kedarshekhar/power_converter_monitering_system/README.md

# power_converter_monitering_system
"This project implements a real-time power converter monitoring system utilizing an ESP32 microcontroller integrated with a USR-TCP232-E2 Ethernet module. A wired Ethernet connection was explicitly chosen over wireless alternatives like Wi-Fi or Bluetooth to guarantee ultra-fast, highly reliable data transmission, achieving a communication latency as low as 4 milliseconds.

some important instruction 

1 turn off windows defender during transferring data because it not allows data coming from unauthorized data 

2 by using vcom software set ip and the port no to the rthernet module ( usr tcp 232 e2 )

3 ip of ur computer should be same network as ur tcp module ip
