kedarshekhar/power_converter_monitering_system/ESP32_Buck_Converter_Project_Report.docx

PROJECT REPORT

ESP32-Based Buck Converter Monitoring & Control System

with TFT Touch-Style UI, C2000 DSP Data Link, Ethernet Telemetry and a Python Desktop GUI

Prepared by: Kedar

Reference source files: IDE_code.ino (ESP32 firmware), python_code_gui.py (desktop GUI)

# 1. Project Overview

This project implements an embedded monitoring-and-control front end for a DC-DC buck converter. An ESP32 microcontroller drives a colour TFT display that shows live output voltage, current and power, reads a bank of six push-buttons for local control, exchanges measurement/command packets with a Texas Instruments C2000-series DSP control board over a dedicated UART link, and simultaneously streams the same telemetry to a Windows/Linux/Mac desktop application over a wired Ethernet connection so the converter can also be watched and operated remotely from a PC.

The system is built from two pieces of source code that were reviewed for this report: the ESP32 firmware written in the Arduino IDE (IDE_code.ino) and the desktop companion application written in Python using Tkinter (python_code_gui.py). The sections below describe the hardware components, the circuit/pin connections exactly as declared in the firmware, the communication protocols used between every pair of devices, and a theoretical walkthrough of both programs so the working of the whole system can be understood end to end.

## 1.1 Key Features

- Live dashboard on a 240x320 TFT screen showing Output Voltage, Current, Power and the user-settable reference voltage (Vref).
- Six hardware push-buttons for ON/OFF, page switching, cursor movement, digit increment/decrement and Save — a small embedded 'menu system'.
- Six-page UI: Dashboard, Voltage waveform, Current waveform, Power waveform, PuTTY-style serial terminal, and a live C2000 data page.
- A binary, hex-text based communication protocol with an external C2000 DSP board for sending the target voltage (Vref) and ON/OFF events, and for receiving back measured voltage, current and power.
- A wired Ethernet bridge (USR-TCP232 serial-to-Ethernet module) that lets a PC application connect over TCP/IP instead of Wi-Fi, for a faster and more reliable link.
- A cross-platform Python/Tkinter GUI that mirrors the on-device dashboard and lets the same six actions be triggered remotely from a PC.

# 2. System Architecture (Block Diagram)

The diagram below was reconstructed directly from the pin definitions, baud rates and communication functions found in the firmware, so it reflects exactly what the code implements rather than a generic reference design.

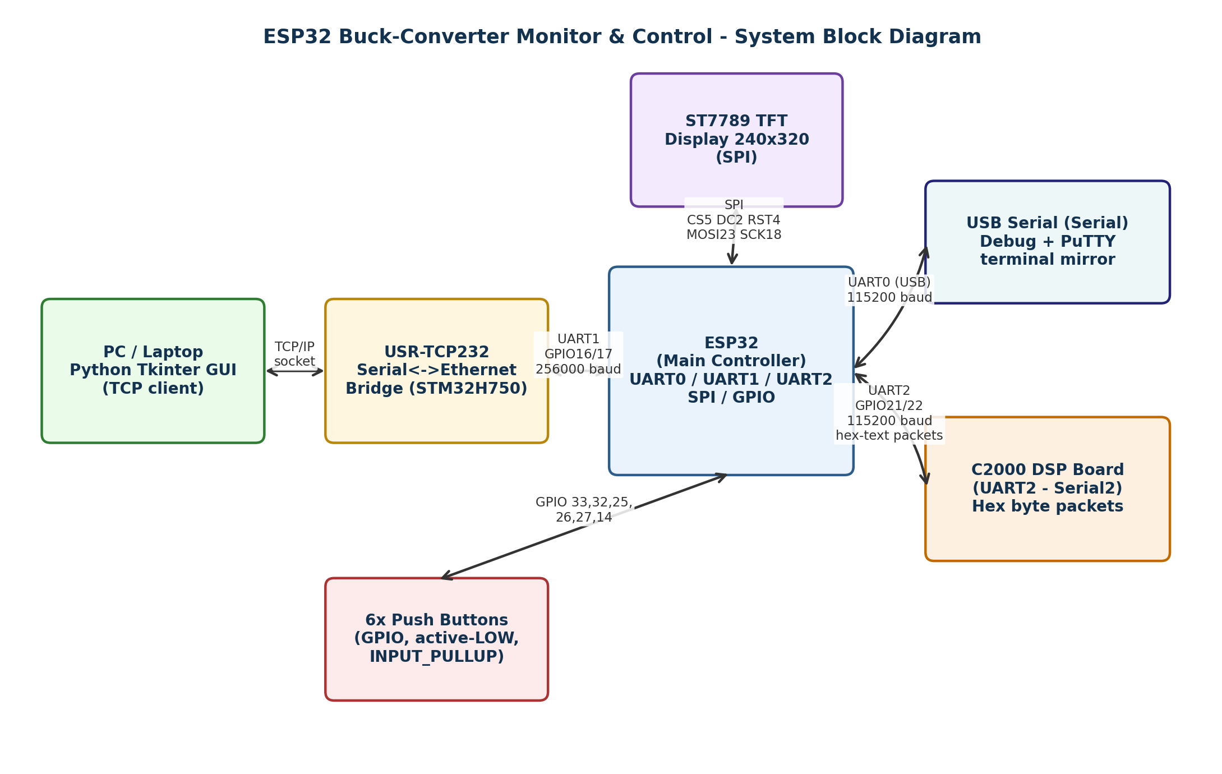
[picture p1: figure]

Five independent communication channels run in parallel on the ESP32: the native USB serial port (UART0) for debugging and PuTTY-style terminal echo, hardware UART2 for the C2000 DSP link, hardware UART1 for the Ethernet bridge to the PC, the VSPI bus for the TFT display, and plain digital GPIOs for the six buttons. All of these are serviced once per pass through the Arduino loop() function, so the firmware behaves as a simple round-robin cooperative multitasker rather than using an RTOS.

# 3. Hardware Components

# | Component | Role in the Project

1 | ESP32 Dev Board | Main controller. Runs the firmware, drives the display over SPI, scans the buttons, and manages all four serial links (USB debug, C2000 UART, Ethernet-bridge UART, plus the SPI bus to the display).
2 | ST7789 TFT Display (240x320) | SPI colour LCD used for the on-device dashboard, waveform pages, terminal page and C2000 data page. Driven with the Adafruit_GFX + Adafruit_ST7789 libraries.
3 | USR-TCP232 Module (STM32H750-based) | Transparent serial-to-Ethernet bridge. Converts UART1 bytes from the ESP32 into TCP packets on the LAN and back, so the PC GUI can talk to the ESP32 as if it were a plain TCP socket. Configured once as a TCP Server (115200/256000-class baud, matching ETH_BAUD).
4 | 6x Momentary Push Buttons | Local user interface: ON/OFF, Next Page (WAVE), Move Cursor, Increment, Decrement and Save. Wired to GPIOs configured with internal pull-ups (active-LOW).
5 | C2000 DSP Control Board (Texas Instruments) | The actual power-stage controller for the buck converter. Receives the target reference voltage and ON/OFF events from the ESP32 and reports back measured voltage, current and power over the same UART link.
6 | PC / Laptop | Runs the Python Tkinter desktop application, which connects to the USR-TCP232 module over TCP/IP to show the same live data and send the same six commands remotely.
7 | Buck Converter Power Stage | The physical DC-DC converter being monitored/controlled (input ~24 V simulated in firmware; the real converter is driven and measured by the C2000 board).

# 4. Circuit Diagram / Pin Connections (from Firmware #define Macros)

The firmware declares every physical connection at the top of IDE_code.ino using #define macros. Cross-checking those macros against the peripheral initialisation calls in setup() gives the exact wiring below — this is effectively the 'circuit diagram' expressed in code form, and is the fastest way to verify that the physical wiring on the board matches what the firmware expects.

## 4.1 TFT Display - SPI Bus (VSPI)

Signal | ESP32 GPIO | Function
TFT_CS | GPIO 5 | Chip Select - tells the display when the ESP32 is addressing it
TFT_DC | GPIO 2 | Data/Command select - distinguishes a command byte from a data byte
TFT_RST | GPIO 4 | Hardware reset line, pulsed LOW then HIGH once at boot
VSPI_MOSI | GPIO 23 | Master-Out-Slave-In - carries pixel/command data to the display
VSPI_MISO | GPIO 19 | Master-In-Slave-Out - rarely used, reserved by the SPI peripheral
SPI_SCK | GPIO 18 | SPI clock, shared timing reference for MOSI

Initialised in code with: SPI.begin(18, 19, 23, TFT_CS); followed by tft.init(240, 320); and tft.setRotation(2); for portrait orientation.

## 4.2 Push Buttons (Digital Inputs, INPUT_PULLUP, Active-LOW)

Button | ESP32 GPIO | Firmware Action When Pressed
BTN_ONOFF | GPIO 33 | Toggles converter output ON/OFF; jumps back to Dashboard; sends ON/OFF signal packet + Vref packet to C2000
BTN_WAVE | GPIO 32 | Cycles through the 6 UI pages (Dashboard -> Voltage -> Current -> Power -> Terminal -> C2000 -> back to Dashboard)
BTN_INC | GPIO 25 | On the Dashboard, increments the Vref digit currently selected by the cursor
BTN_DEC | GPIO 26 | On the Dashboard, decrements the Vref digit currently selected by the cursor
BTN_SAVE | GPIO 27 | Sends the currently-set Vref value to the C2000 board and shows a 'SET!' badge for 1 second
BTN_CURSOR | GPIO 14 | Moves the digit-edit cursor across the 4 Vref digits (tens, ones, first decimal, second decimal)

Each pin is read every loop() pass with a 40 ms software debounce window (checkButtons()), and because INPUT_PULLUP is used, an un-pressed button reads HIGH and a pressed button pulls the line LOW.

## 4.3 UART2 - Link to the C2000 DSP Board

Signal | ESP32 GPIO | Notes
RXD2 | GPIO 21 | ESP32 receives hex-text byte packets sent by the C2000 board
TXD2 | GPIO 22 | ESP32 transmits hex-text byte packets (Vref, ON/OFF signals) to the C2000 board

Configured with Serial2.begin(115200, SERIAL_8N1, RXD2, TXD2); - 115200 baud, 8 data bits, no parity, 1 stop bit.

## 4.4 UART1 - Link to the USR-TCP232 Ethernet Bridge

Signal | ESP32 GPIO | Notes
ETH_RXD | GPIO 16 | ESP32 UART1 RX <- module's TXD pad
ETH_TXD | GPIO 17 | ESP32 UART1 TX -> module's RXD pad

Configured with EthSerial.begin(256000, SERIAL_8N1, ETH_RXD, ETH_TXD); using ESP32 HardwareSerial channel 1. The USR-TCP232 module must separately be configured once (via USR-VCOM or its web page) as a TCP Server with a matching serial baud rate, and its Local Port (e.g. 8899) and IP address must match MODULE_IP / MODULE_PORT in the Python GUI.

## 4.5 Native USB Serial (UART0)

Used only for Serial.begin(115200) debug prints and for mirroring anything typed into a PC terminal program (e.g. PuTTY, or the Arduino Serial Monitor) onto the on-device 'PuTTY Terminal' page - no extra GPIOs are needed since this runs over the same USB cable used to program the board.

# 5. Communication Protocols

The firmware defines three distinct application-level protocols, one for each communication partner. All of them were reconstructed directly from the sendByteAsHex(), sendVrefPacket(), sendOnSignalPacket(), sendOffSignalPacket(), handleC2000Packet() and broadcastEthernetData() functions in IDE_code.ino.

## 5.1 ESP32 -> C2000: Vref Packet (sent on SAVE, and automatically on ON/OFF)

Byte index | Value | Meaning
0 | 0x00 | Fixed header identifying this as a Vref packet
1-4 | 4 bytes | The Vref value as an IEEE-754 32-bit float, Little-Endian byte order
5 | 0x00 | Fixed footer

Each byte is sent as its own line of ASCII text formatted like "0xA1" (see sendByteAsHex()), one byte per line, over Serial2 (and echoed to the USB debug port).

## 5.2 ESP32 -> C2000: ON / OFF Signal Packets

Event | Bytes [0..4] | Byte [5]
Output turned ON | 0x11, 0x11, 0x11, 0x11, 0x11 | 0x00
Output turned OFF | 0x12, 0x12, 0x12, 0x12, 0x12 | 0x00

A signal packet is always immediately followed by one Vref packet - the current target voltage on the ON transition, or the zeroed value on the OFF transition - even if SAVE was never pressed.

## 5.3 C2000 -> ESP32: Measurement Packets

Byte index | Value | Meaning
0 | 1 / 2 / 3 | Header identifying the payload: 1 = Voltage, 2 = Current, 3 = Power
1-4 | 4 bytes | The measured value as an IEEE-754 32-bit float, Little-Endian
5 | 0x00 | Required footer; the packet is discarded if this byte is not 0x00

checkC2000Input() reassembles these packets from incoming "0xXX" text lines on Serial2 and hands each complete 6-byte packet to handleC2000Packet(), which decodes the float and updates c2000Voltage, c2000Current or c2000Power depending on the header byte.

## 5.4 ESP32 -> PC GUI: Live Telemetry (Ethernet, JSON)

Every 8 ms, broadcastEthernetData() builds and transmits one single-line JSON object over the Ethernet-bridge UART (about 125 packets/second):

{"outputActive":false,"voltage":0.00,"current":0.00,"power":0.00,

"vref":0.00,"c2000Voltage":0.00,"c2000Current":0.00,"c2000Power":0.00,

"page":"DASHBOARD","cursorIndex":0}

The Python GUI's background reader thread parses each newline-terminated JSON line and stores only the latest one; a separate fixed-rate Tkinter timer (every 30 ms) repaints the on-screen labels from that latest value, so a fast incoming data stream never floods or freezes the GUI.

## 5.5 PC GUI -> ESP32: Commands (Ethernet, plain text)

Command string | Equivalent physical button | Firmware action
TOGGLE_OUTPUT | BTN_ONOFF | Flips output ON/OFF
NEXT_PAGE | BTN_WAVE | Advances to the next UI page
MOVE_CURSOR | BTN_CURSOR | Moves the Vref digit cursor
INC_DIGIT | BTN_INC | Increments the selected Vref digit
DEC_DIGIT | BTN_DEC | Decrements the selected Vref digit
SAVE | BTN_SAVE | Sends the Vref packet, shows the SET! badge
SET_VREF:12.34 | (no physical equivalent) | Directly sets Vref to a typed value (0-99.99), recalculates, and immediately sends the Vref packet to the C2000 board

Each command is one line of plain ASCII text terminated with \n. handleGuiCommand() parses the line and, for the first six commands, simply calls the same handleButtonPress() function used for the physical buttons - guaranteeing the GUI and the hardware buttons always behave identically.

# 6. Theoretical Working of the Buck Converter Model in Firmware

Inside the ESP32 firmware, the converter's electrical behaviour is represented with a simple simulated model (the real measured values ultimately come from the C2000 board, but this model drives the on-device display so it remains responsive even without a live C2000 connection):

outputVoltage = inputVoltage x dutyCycle x efficiency (efficiency assumed = 0.92)

dutyCycle = Vref / inputVoltage (clamped between 5% and 95%)

outputPower = outputVoltage x outputCurrent

This mirrors the fundamental steady-state buck converter relationship Vout = D x Vin (ideal case), extended with an efficiency factor. inputVoltage is itself simulated with small random drift (23.5-23.8 V) every 100 ms inside loop(), and outputCurrent is simulated as a random value between 1.5 A and 3.5 A whenever the output is active, purely to make the on-device waveform pages and numeric readouts look 'alive' during bench testing without a live C2000 link.

# 7. ESP32 Firmware (IDE_code.ino) - Theoretical Walkthrough

The firmware is organised as a classic Arduino program: one setup() that runs once, and one loop() that repeats forever, supported by a large set of helper functions grouped by responsibility.

## 7.1 Libraries and Global Definitions

- SPI.h, Adafruit_GFX.h, Adafruit_ST7789.h - provide the low-level SPI transport and the drawing primitives (text, lines, rectangles) used to build every screen.
- math.h - supplies sin(), used to draw the smooth Power-waveform page.
- A ScreenPage enum (PAGE_DASHBOARD ... PAGE_C2000) defines the six on-device screens as named constants instead of magic numbers, and currentPage tracks which one is active.
- A set of 16-bit RGB565 COLOR_* macros define the entire colour palette once at the top, so every drawing function reuses the same theme.
- A Button struct plus a buttons[] array bundle each button's pin, last raw reading, debounce timestamp and 'already handled' flag together, which is what makes the generic checkButtons() loop possible instead of writing six near-identical blocks of code.

## 7.2 setup()

Runs once at power-on / reset, in this order:

- Starts the USB debug serial port and UART2 (for the C2000 link).
- Configures all six button pins as INPUT_PULLUP.
- Seeds the random-number generator from analog noise on pin 34, so the simulated current/voltage jitter is different on every boot.
- Starts the SPI bus and manually pulses the TFT_RST pin low-then-high to force a clean display power-on reset.
- Initialises the ST7789 driver at 240x320 and sets portrait rotation.
- Computes the initial buck-converter values and draws the first Dashboard screen.
- Sends the OFF signal packet and a zeroed Vref packet to the C2000 board once at boot, so the DSP board always starts from a known state that matches the display.
- Finally starts the Ethernet-bridge UART via setupEthernetLink().

## 7.3 loop()

Executed continuously; each pass performs five jobs in sequence, none of which use blocking delay() calls, which is what keeps the UI and both serial links responsive at the same time:

- checkButtons() - scans all six buttons for a new, debounced press.
- checkPuttyInput() - drains any bytes typed into the USB serial monitor / PuTTY and appends completed lines to the on-screen terminal buffer.
- checkC2000Input() - drains any bytes arriving from the C2000 board and reassembles them into 6-byte measurement packets.
- checkEthernetInput() - drains any command bytes arriving from the Python GUI over the Ethernet bridge.
- A timed block that calls broadcastEthernetData() once every 8 ms (~125 Hz) to keep the PC GUI's live view up to date.
- A timed block that hides the 'SET!' badge one second after it was shown.
- A second timed block, running every 100 ms, that re-randomises the simulated input voltage/current and recalculates all buck-converter values, refreshing the Dashboard numbers if that page is currently visible.

## 7.4 Button Handling - checkButtons() and handleButtonPress()

checkButtons() implements standard software debouncing: for each button, if the raw pin reading changes it restarts a timer; only once the reading has been stable for 40 ms is a LOW level (pressed, because of the pull-up) accepted as a genuine press, and a 'pressed' flag stops the same press from being registered repeatedly until the button is released again. Once a clean press is confirmed, handleButtonPress(pin) is called with the GPIO number, and a switch-style dispatch decides what that specific button should do - described in detail in section 4.2 above. Because handleGuiCommand() (section 5.5) calls this exact same function, the physical buttons and the remote GUI commands are guaranteed to produce identical behaviour.

## 7.5 Display / Drawing Functions

- clearEntireScreen() / drawOuterBorder() - wipe the screen and draw a 4-pixel nested-rectangle border reused on every page.
- drawDashboard() - draws section labels and dividers, then calls updateValues(), drawStatusArea() and drawVref() to fill in the live numbers, the ON/OFF pill and the Vref entry bar.
- updateValues() - redraws only the three big numeric readouts (Voltage/Current/Power) without redrawing the whole page, which avoids visible flicker on every refresh.
- drawStatusArea() - draws the ON (magenta) / OFF (cyan) pill button and, for one second after SAVE is pressed, a pink 'SET!' confirmation badge.
- drawVref() - draws the four-digit Vref entry field and a moving yellow highlight block showing which digit the cursor currently points to.
- drawVoltagePage() / drawCurrentPage() / drawPowerPage() - draw stylised square-wave, triangle-wave and sine-wave graphics respectively, purely as illustrative waveform icons (using drawFastHLine/drawFastVLine/drawLine and, for the sine wave, the sin() function from math.h) rather than a true oscilloscope trace.
- drawTerminalPage() - renders the last up-to-12 lines typed on the USB serial console, in a small monospace-style font.
- drawC2000Page() - shows the most recently received Voltage/Current/Power values from the C2000 board, each independently marked as 'received' or '--' until its first packet arrives, plus a 'last update N s ago' indicator.

## 7.6 C2000 Communication Functions

- floatToLE4Bytes() - uses a C union to reinterpret a float's raw 4 bytes of memory without changing its value, giving an exact IEEE-754 byte representation to transmit.
- sendByteAsHex() - formats one byte as "0xXX" text and prints it as its own line to both Serial2 (to the C2000 board) and the USB debug port.
- sendOnSignalPacket() / sendOffSignalPacket() / sendVrefPacket() - build and transmit the three outgoing packet types described in section 5.1/5.2.
- checkC2000Input() / handleC2000Packet() - the receive-side counterpart described in section 5.3, converting incoming hex-text lines back into a 6-byte binary packet and then into a float.

## 7.7 Ethernet / GUI Link Functions

- setupEthernetLink() - starts HardwareSerial channel 1 at 256000 baud on the ETH_RXD/ETH_TXD pins that connect to the USR-TCP232 module.
- checkEthernetInput() - buffers incoming characters until a newline, then passes the completed command line to handleGuiCommand() (with a 64-character safety cap to discard any runaway/garbled line).
- handleGuiCommand() - the command interpreter described in section 5.5, reusing handleButtonPress() wherever possible.
- broadcastEthernetData() - builds the JSON telemetry line described in section 5.4 and prints it once per call.

# 8. Python Desktop GUI (python_code_gui.py) - Theoretical Walkthrough

The companion application is a single-file Tkinter program (no third-party libraries required - it uses only the standard tkinter, threading, json and socket modules) that mirrors the ESP32 dashboard on a PC and lets the same six control actions be triggered remotely.

## 8.1 Configuration

Three constants at the top of the file are the only things that normally need editing: MODULE_IP and MODULE_PORT must match the static IP and Local Port configured on the USR-TCP232 bridge module, and GUI_REFRESH_MS (default 30 ms) sets how often the on-screen labels are repainted, independent of how fast the ESP32 is actually sending data.

## 8.2 Threading Model

The application deliberately splits work across three concurrent activities so that a slow or dropped network connection can never freeze the window:

- Main thread - runs Tkinter's own event loop (root.mainloop()); this is the only thread allowed to touch widgets directly, and it also hosts the fixed-rate _schedule_gui_refresh() timer that repaints labels every GUI_REFRESH_MS.
- Connection thread (_connect_loop) - a background daemon thread that opens a TCP socket to the USR-TCP232 module, and automatically retries every 2 seconds if the connection is refused or drops, updating a status label (Connecting.../Connected/Disconnected) via root.after() so the update is safely marshalled back onto the main thread.
- Read thread (_read_loop, invoked from inside the connection thread) - blocks on socket.recv(), accumulates bytes into a buffer, splits it into newline-terminated JSON lines, parses each with json.loads(), and stores only the single most recent parsed dictionary behind a threading.Lock().

Decoupling the network read rate (up to ~125 packets/second from the ESP32) from the GUI repaint rate (every 30 ms) is an important design choice: Tkinter cannot safely repaint faster than the screen refreshes anyway, so buffering only the latest value avoids wasting CPU time on discarded intermediate frames.

## 8.3 UI Layout

- A Dashboard (Local) section with five live value rows: Output Status, Output Voltage, Output Current, Output Power and Target Vref.
- A C2000 Board Data section mirroring the three values received from the DSP board.
- A Controls section with six buttons (Toggle ON/OFF, Next Page, Move Cursor, Increment, Decrement, Save) laid out in a 3-row grid, each wired directly to the matching _send() command.
- A direct Vref entry box plus a 'Send Vref' button that validates the typed number and transmits a SET_VREF:<value> command.
- A status row showing the current on-device Page name and the currently selected cursor digit, both driven by the same JSON telemetry stream.

## 8.4 Sending Commands - _send()

Every button is wired to a small wrapper method (toggle_output(), next_page(), move_cursor(), inc_digit(), dec_digit(), save_vref(), set_vref()) that ultimately calls the shared _send(command) helper. This appends a newline to the command string and writes it to the socket, under a lock, so it can never race with a new connection being swapped in by the reconnect thread; any socket error is silently caught, since the reconnect loop is what will restore the link.

## 8.5 Overall Data Flow (End to End)

- Button press (physical, on the ESP32 board) OR button click (Python GUI) both funnel into the same handleButtonPress()/handleGuiCommand() logic on the ESP32 firmware.
- The firmware updates its internal state, redraws the affected TFT page, and (for ON/OFF/SAVE/SET_VREF) sends the relevant packet(s) to the C2000 board over UART2.
- The C2000 board actually controls the physical buck converter and periodically reports measured Voltage/Current/Power back over the same UART2 link.
- The firmware folds all of this state - local simulated values, C2000-reported values, current page and cursor position - into one JSON object every 8 ms and streams it out over UART1 to the USR-TCP232 Ethernet bridge.
- The bridge module forwards those bytes transparently as TCP packets to any connected client - in this case, the Python GUI's read thread - closing the loop so the PC display always tracks the physical hardware in near real time.

# 9. Circuit / Connection Verification Checklist

Because every physical connection is declared as a named constant in the firmware, the wiring can be verified quickly by checking each item below against the actual board before power-up:

- TFT: CS->GPIO5, DC->GPIO2, RST->GPIO4, SCK->GPIO18, MOSI->GPIO23, (MISO->GPIO19 optional/unused by most displays), plus 3V3 and GND.
- Buttons: one leg of each button to its listed GPIO (33/32/25/26/27/14), the other leg to GND - no external resistor is required since INPUT_PULLUP is enabled in software.
- C2000 link: ESP32 GPIO21 (RX2) to the C2000 board's TX line, ESP32 GPIO22 (TX2) to the C2000 board's RX line, common GND between both boards, both sides set to 115200-8N1.
- Ethernet bridge: ESP32 GPIO16 (RX1) to the USR-TCP232 module's TXD pad, ESP32 GPIO17 (TX1) to the module's RXD pad, common GND, both sides matched to 256000-8N1 (ETH_BAUD).
- USR-TCP232 module itself must be pre-configured (one time, via USR-VCOM or its web UI) as a TCP Server on a known static IP and Local Port, which must then be copied into MODULE_IP / MODULE_PORT in the Python script.
- USB cable from the ESP32 to the PC is only required for programming and for the debug/PuTTY terminal feature - it is not used for the live GUI link, which runs entirely over the Ethernet bridge.

# 10. Conclusion

The project combines a locally self-contained embedded UI (TFT + 6 buttons) with two independent serial links - one to a real power-electronics DSP controller (C2000) and one, bridged over Ethernet, to a desktop monitoring application. The firmware's cooperative, non-blocking loop() design lets it service the display, the buttons and three simultaneous serial channels without ever stalling, while a small, well-defined hex-byte packet protocol keeps the ESP32<->C2000 link simple and robust, and a JSON-over-TCP telemetry stream keeps the PC GUI effectively real-time. Reviewing the firmware's #define pin macros against the Python script's configuration constants is sufficient to fully reconstruct and verify the system's wiring and communication setup, as documented in Sections 4, 5 and 9 of this report.

ESP32 Buck Converter Monitor - Project Report
