kedarshekhar/power_converter_monitering_system/Schematic_keypadTFTdisplay.pdf

0

0

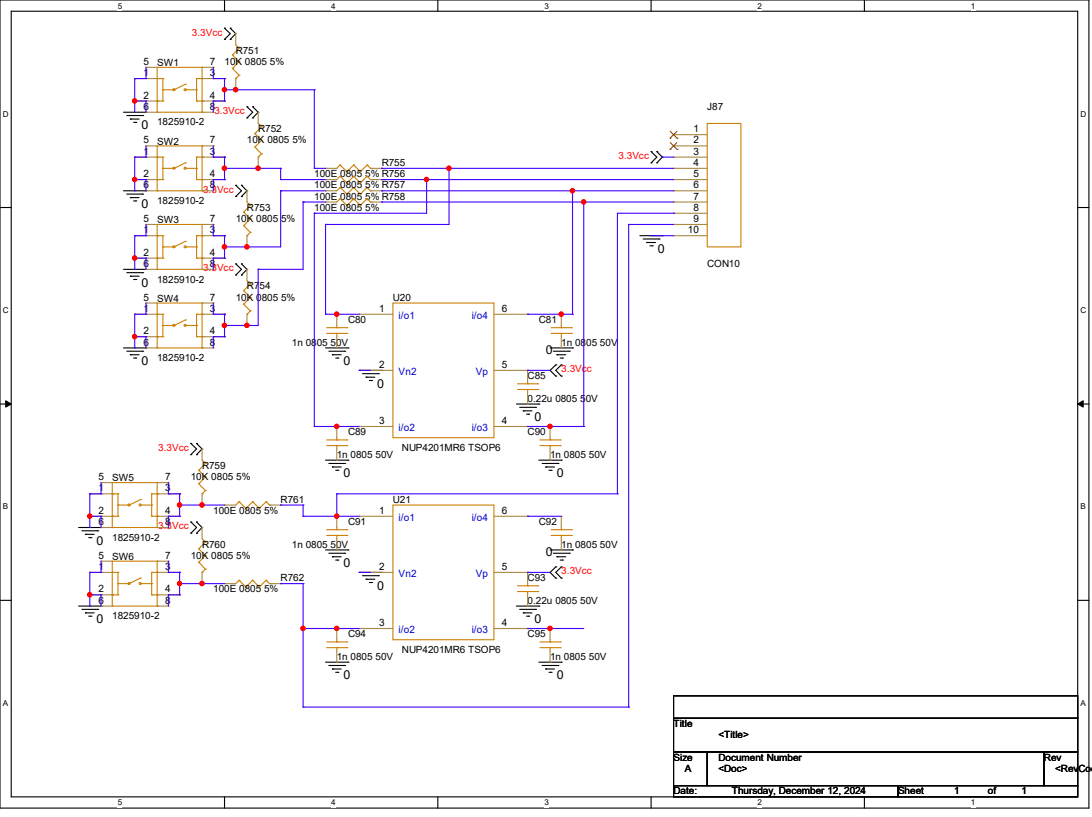
[picture p2: page 1]

0

# J85 CON14

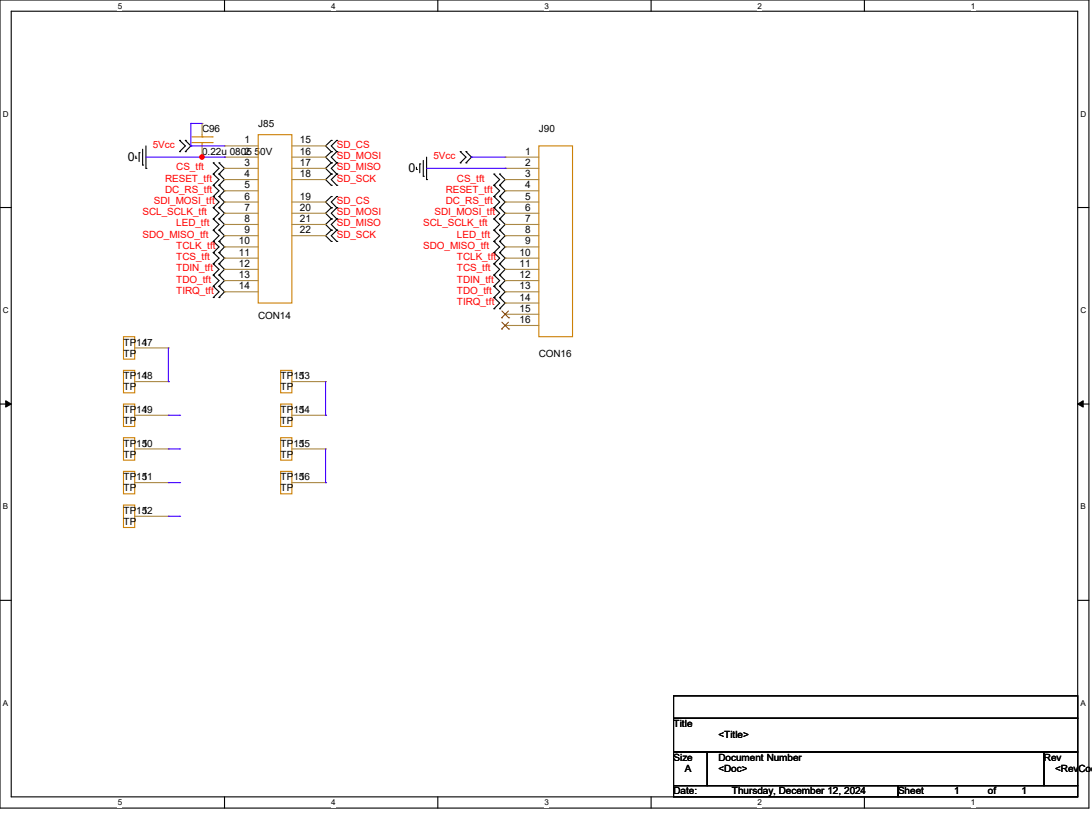
[picture p3: page 2]
